IvaShuba/embedded-current-monitor-pcb/(commit log)

2026-05-06 Enhance README with project details and results
    Expanded the README to include detailed project overview, implementation steps, results, and challenges encountered during the PCB design and assembly process.
2026-05-06 Add files via upload
    uC code for basic setup. Include: ADC for currents, SPI to extension board for sensor data, I2C to display temp on screen and preparing JSON string for dashboard on SerialUSB.
